jay-hamlin/charlieplexClock/Clock_README.rtf

7 segment clock using LED filaments.
Last update 24, March 2022.
Jay Hamlin

HISTORY
The inspiration for this project came from one of Big Clive’s YouTube videos in which he was showing low voltage LED filaments. This was new to me, I didn’t know that there were LED filaments that ran on 3 Volts. I bought some 38mm white, 3 Volt filaments on AliExpress and soldered them together as a 7 segment digit on a prototyping board just to see what they would look like. It looked ok but I didn’t know what I would do with it. Later I bought some 20mm red filaments , their color is more red-orange which reminded me of neon. The LED Nixie tube was born!

My first take on the LED nixie was to solder 7 segments together in free space using heavy gauge wires for the supports on the bottom segments and the finest wire I could find (10um diameter!) for the others thinking this would look most like a Nixie tube. It looked good but the 10um wire was very difficult to work with and it took forever to hand solder the segments. I didn’t think I could make any two that looked alike even after making a simple jig to hold the segments in place.

I tried putting the hand made digit into a small glass jar as the first try at making the tube part of the Nixie tube. It worked but the shape of the jar wasn’t very good, not so tube like. Then I had the idea to use a laboratory test tube with a rounded end. You can get test tubes made from plastic on Amazon for cheap - the product description says that the tubes are 2 liter soda bottles before they have been expanded. Perfect!

Then I decided that it would be ok to use a black pcb to hold the segments, this way every digit would come out the same and it would be much easier to assemble so I made a pcb sized to fit inside the test tube. I used OSHPark to fab the boards using their After Dark service for the black substrate.

By the way, the 20mm filaments have an active (light emitting) length of only 11mm. I made the pcb with solder pads 14mm apart and a slot for the LED 11.5mm long by 2.0mm wide. This size works really well although you do have to trim some of the extra metal off of the ends of the filament and trim the silicone just a bit with an Exacto knife.

The clock is my way of showing off the LED Nixie tubes with something interesting. What else would I have made? A frequency counter perhaps but the clock seemed more useful. I choose Adafruit’s HUZZAH32 Feather board with the ESP32 because it had WiFi and I could program it in circuit python which sounded like something which would be good to learn. When I got into it, I ended up porting the Arduino Uno single digit code to the ESP32 and the 6 74LV595 shift registers and had a working Arduino project before I could even start with the circuit python. So, Arduino it is, circuit python for some other day!

CHARLIEPLEXING
wiki entry: https://en.wikipedia.org/wiki/Charlieplexing
YouTube explainer: https://youtu.be/Bx5GLyJSWPk

Why did I use Charlieplexing for this project? Because I wanted the segments to be as close to each other as possible - connecting them together at each intersection was the simplest and most direct method. Also, the prototype digit was made without any pcb, the solder connections were also the mechanical mounting points of the segments, they couldn’t be wired in the more conventional common cathode or common anode arrangement and hold together.

HARDWARE
The schematics and pcb were designed in KiCAD 5.1.12. There are 2 projects, one for the digit pcb and another for the main board.

A complete clock is made up of 3 boards:
1- One main pcb
2- Six digit pcbs which plug into the main pcb at J3, J4, J6, J7, J9 and J10.
3- Two colon pcbs which plug into the main pcb at J5 and J8.

DIGIT PCB:
KiCAD_Project/7SegmentCharlie.pro
The digit pcb schematic PDF is: KiCAD_Project/7segmentCharlie.pdf
MAIN BOARD:
KiCAD_Project/6DigitCharlieplex.pro
The main board pcb schematic PDF is: KiCAD_Project/ClockSchematic_02232222.pdf
COLON PCB:
/Documentation/colon_dim_drawing.pdf
There are no KiCAD files for the colons, these were hand made from prototyping boards. The “schematic” is in the drawing file.

BILL OF MATERIALS:
KiCAD_Project/BOM_03232022.xlsx

DOCUMENTS
/Documentation/Arduino_Proto_7seg_Display.pdf
The original schematic for the Arduino Uno digit prototype. Note that the LED for segment D is shown backwards, I actually had it this way at first but then realized all the horizontal segments should all go in the same direction. In fact, by having all the segments in the same direction, the port bits never needed to be in the tri-state state, just ‘1’ or ‘0’ would work which is important in the final clock which uses ‘595 shift registers.
/Documentation/Charlieplex_digit_decoder.pdf
Explanation of how each digit connects to the 74LV595 shift register and the values software writes to produce numbers.
/Documentation/mlb_dim_drawing2.pdf
A dimensioned drawing of the main board.
/Documentation/digit_dim_drawing.pdf
A dimensioned drawing of the digit board.
/Documentation/colon_dim_drawing.pdf
A dimensioned drawing of the colon board.

SOFTWARE
There are 2 Arduino projects as follows:
Arduino/charley7/
Charlie7 is the single digit prototype project running on an Arduino Uno.
The Charlie7 digit schematic is Documentation/Arduino_Proto_7seg_Display.pdf

Arduino/FilamentClock_ESP32/
FilamentClock_ESP32 is the full clock project. It uses the Adafruit HUZZAH32 ESP32 Feather board module. Follow the instructions on Adafruit for getting the HUZZAH32 running with Arduino here: https://learn.adafruit.com/adafruit-huzzah32-esp32-feather/using-with-arduino-ide

LINKS TO LED FILAMENTS:

20mm, 3V, 100mA used in this project: 20mm Filament (https://www.aliexpress.com/item/1005003509056672.html?spm=a2g0o.order_list.0.0.21ef18028wNrUJ). These come in white, red, green, blue and pink. I used the red ones for my project, they look more orange to me which is how I got the Nixie tube inspiration. This is a 6 digit clock which uses 7 filaments per digit or 42 filaments total.

The original prototype Charlieplexed 7 segment digit used 38mm filaments: 38mm filament (https://www.aliexpress.com/item/4000478265055.html). I could have made the clock using these but they seemed just a little too big.

I have also played with 130mm filaments I call “LED spaghetti” but haven’t attempted to make anything with them. Still, they look cool. LED Spaghetti (https://www.aliexpress.com/item/1005001685226898.html?spm=a2g0o.order_list.0.0.21ef18028wNrUJ)

ACRYLIC “TUBES”
I used 25mm diameter plastic test tubes from Amazon then cut them to the size I wanted.
Amazon link: https://www.amazon.com/dp/B07RX6HQPB?psc=1&ref=ppx_yo2_dt_b_product_details

GIT NOTES
git status
git add <file>
git rm <file>
git commit -m “chekin comment”
git push -u origin master
