jay-hamlin/charlieplexClock/Arduino/FilamentClock_ESP32/notes_esp32.rtf

Example code

https://github.com/espressif/arduino-esp32/tree/master/libraries

For the Jar pcb we need
