jay-hamlin/charlieplexClock/KiCAD_Project/BOM_03232022.xlsx

Reference | Count | Value | Footprint | Description | Manufacturer | MPN | Vendor | Vendor PN
C3,C4,C5,C7,C9,C10,C11 | 7 | 100nF | Capacitor_SMD:C_0603_1608Metric | CAP CER 0.1UF 16V X7R 0603 | Yageo | CC0603JRX7R7BB104 | Digikey | 311-1776-1-ND
C6 | 1 | 1uF, 0603 | Capacitor_SMD:C_0603_1608Metric | CAP CER 1UF 16V X7R 0603 | TDK | CGA3E1X7R1C105K080AC | Digikey | 445-12539-1-ND
C8 | 1 | 10uF, 0805 | Capacitor_SMD:C_0805_2012Metric | CAP CER 22UF 10V X5R 0805 | Murata | GRM21BR61A226ME51L | Digikey | 490-10511-1-ND
D13,D14 | 2 | RED_LED | LED_SMD:LED_1206_3216Metric | LED RED CLEAR 1206 SMD | Lite-ON | LTST-C150KRKT | Digikey | 160-1405-1-ND
R1,R2,R3,R4,R5,R6,R7,R8,R9,R10,R11,R12,R15,R16,R17,R18,R19,R20,R23,R24,R25,R26,R27,R28,R29,R30,R31,R32,R33,R34,R37,R38,R39,R40,R41,R42 | 36 | 10R | Resistor_SMD:R_0603_1608Metric | RES 10 OHM 1% 1/8W 0603 | Stackpole | RNCP0603FTD10R0 | Digikey | RNCP0603FTD10R0CT-ND
R21,R22,R35,R36 | 4 | 120R | Resistor_SMD:R_0603_1608Metric | RES 120 OHM 1% 1/10W 0603 | Yageo | RC0603FR-07120RL | Digikey | 311-120HRCT-ND
R13,R14 | 2 | 1K | Resistor_SMD:R_0603_1608Metric | RES SMD 1K OHM 1% 1/3W 0603 | Vishay | CRCW06031K00FKEAHP | Digikey | 541-1.00KSCT-ND
R44 | 1 | 63.4K,1% | Resistor_SMD:R_0603_1608Metric | RES 63.4K OHM 1% 1/10W 0603 | Stackpole | RMCF0603FT63K4 | Digikey | RMCF0603FT63K4CT-ND
R43,R45,R46,R47,R48,R49,R50,R51 | 8 | 100K,1% | Resistor_SMD:R_0603_1608Metric | RES 100K OHM 1% 1/16W 0603 | Yageo | AF0603FR-07100KL | Digikey | 13-AF0603FR-07100KLCT-ND
RV1 | 1 | 10.0K | Potentiometer_THT:Potentiometer_Bourns_3386C_Horizontal | TRIMMER 10K OHM 0.5W PC PIN SIDE | Bourns | 3386H-1-103LF | Digikey | 3386H-103LF-ND
J1,J2,J3,J4,J6,J7,J9,J10 | 8 | Conn_01x06_Female | Connector_PinHeader_2.54mm:PinHeader_1x06_P2.54mm_Vertical | CONN RCPT 6POS 0.1 TIN-LEAD PCB | 3M | 929974-01-06 | Digikey | 929974-01-06-ND
J5,J8 | 2 | Conn_01x03_Female | Connector_PinHeader_2.54mm:PinHeader_1x03_P2.54mm_Vertical | CONN RCPT 3POS 0.1 TIN-LEAD PCB | 3M | 929974-01-03 | Digikey | 929974-01-03-ND
JP1_Feather1 | 1 | Feather_16pin | Connector_PinHeader_2.54mm:PinHeader_1x16_P2.54mm_Vertical | CONN RCPT 16POS 0.1 TIN PCB | 3M | 929974-01-16-RK | Digikey | 929974E-01-16-ND
JP3_Feather1 | 1 | Feather_12pin | Connector_PinHeader_2.54mm:PinHeader_1x12_P2.54mm_Vertical | CONN RCPT 12POS 0.1 TIN PCB | 3M | 929974-01-12-RK | Digikey | 929974-01-12-ND
SW1,SW2,SW3,SW4 | 4 | SW_Push | Button_Switch_SMD:SW_SPST_PTS645 | SWITCH TACTILE SPST-NO 0.05A 12V | C&K | PTS645SH50SMTR92 LFS | Digikey | CKN9085CT-ND
SW5 | 1 | SW_DIP_x03 | Package_DIP:DIP-6_W8.89mm_SMDSocket_LongPads | SWITCH SLIDE DIP SPST 100MA 20V | CTS | 219-3LPSTR | Digikey | CT3115CT-ND
U1,U2,U4,U5,U6,U7 | 6 | 74LV595D,118 | Package_SO:SO-16_3.9x9.9mm_P1.27mm | IC 8BIT SHIFT REGISTER 16SOIC | Nexperia | 74LV595D,118 | Digikey | 1727-7348-1-ND
U3 | 1 | NCV8164ASNADJT1G | Package_TO_SOT_SMD:TSOT-23-5 | IC REG LIN POS ADJ 300MA 5TSOP | ON Semi | NCV8164ASNADJT1G | Digikey | 488-NCV8164ASNADJT1GCT-ND
HUZZAH32 | 1 | ESP32 Feather | custom | ESP32 Feather boar HUZZAH32 | Adafruit | 3405 | Adafruit | 3405
LED Filaments | 42 | 20mm,RED,3V |  | AliExpress https://www.aliexpress.com/item/1005003509056672.html?spm=a2g0o.order_list.0.0.21ef18028wNrUJ
Digit PCB | 1 |  |  | OSHPark, "After Dark", black substrate and clear soldermask
Main PCB | 1 |  |  | OSHPark, "After Dark", black substrate and clear soldermask
