jay-hamlin/charlieplexClock/Documentation/Arduino_Proto_7seg_Display.pdf

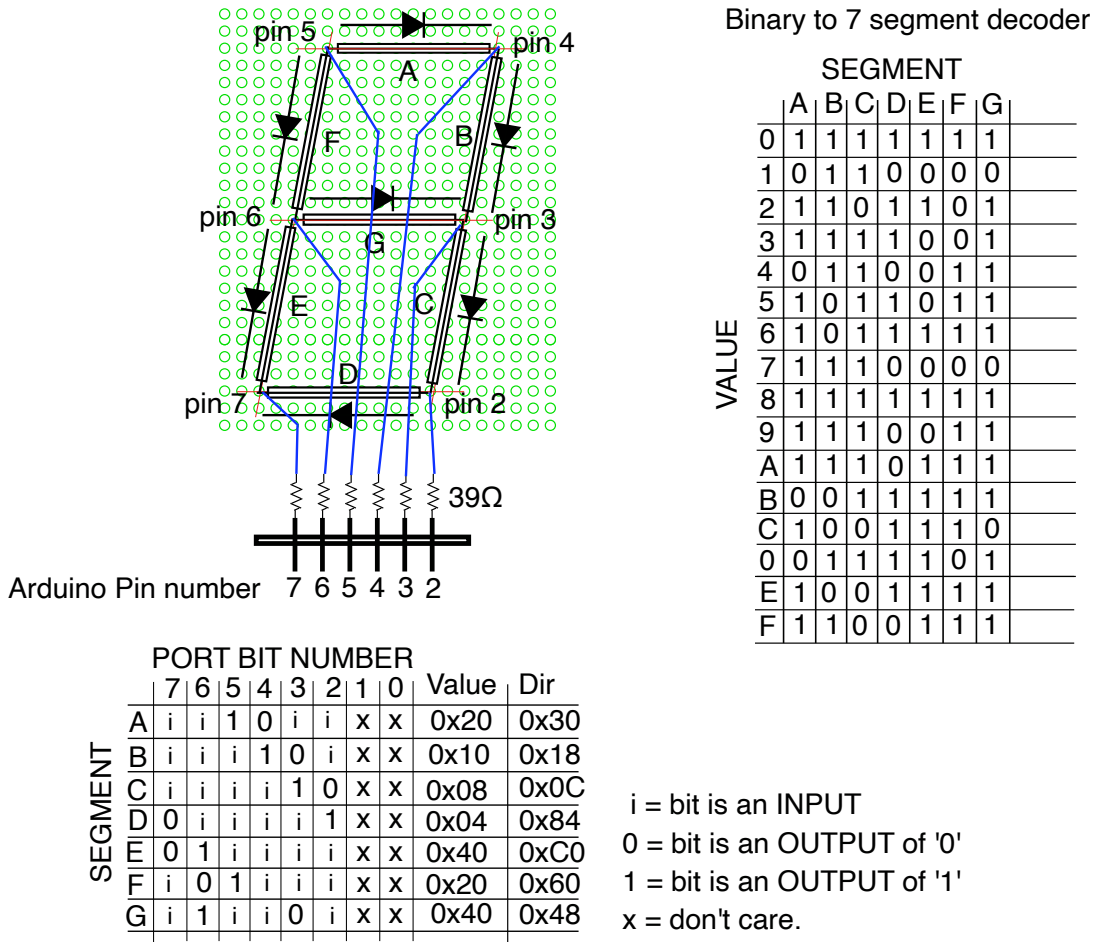
[picture p1: page 1]
PORT BIT NUMBER; SEGMENT; Value; Dir 0x30 0x18 0x0C 0x84 0xC0 0x60 0x48; VALUE; pin 4; pin 3; pin 7; pin 2; pin 6; pin 5

Binary to 7 segment decoder

Arduino Pin number

i = bit is an INPUT
0 = bit is an OUTPUT of '0'
1 = bit is an OUTPUT of '1'
x = don't care.
