jay-hamlin/charlieplexClock/Documentation/Charlieplex_digit_decoder.pdf

# CHARLIEPLEXED CLOCK DIGIT DECODER

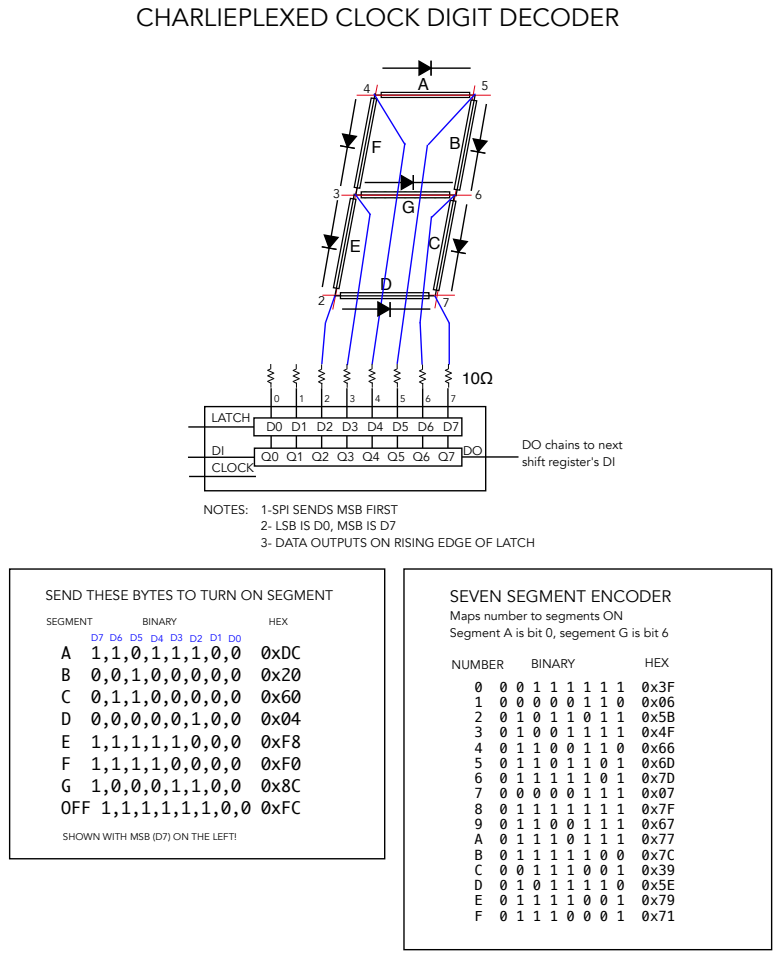
[picture p2: page 1]

DO chains to next
shift register's DI

NOTES: 1-SPI SENDS MSB FIRST

2- LSB IS D0, MSB IS D7
3- DATA OUTPUTS ON RISING EDGE OF LATCH

SEND THESE BYTES TO TURN ON SEGMENT

SEVEN SEGMENT ENCODER
Maps number to segments ON
Segment A is bit 0, segement G is bit 6

SHOWN WITH MSB (D7) ON THE LEFT!
