jay-hamlin/charlieplexClock/Documentation/colon_dim_drawing.pdf

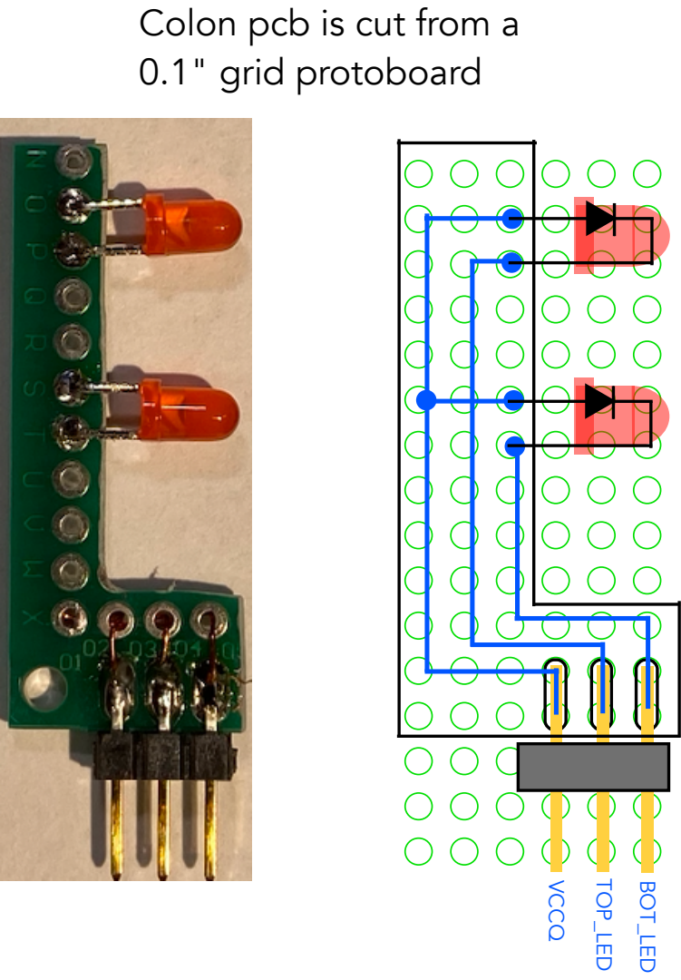
[picture p3: page 1]
VCCQ; TOP_LED; BOT_LED

Colon pcb is cut from a
0.1" grid protoboard
