jay-hamlin/charlieplexClock/KiCAD_Project/ClockSchematic_02232222.pdf

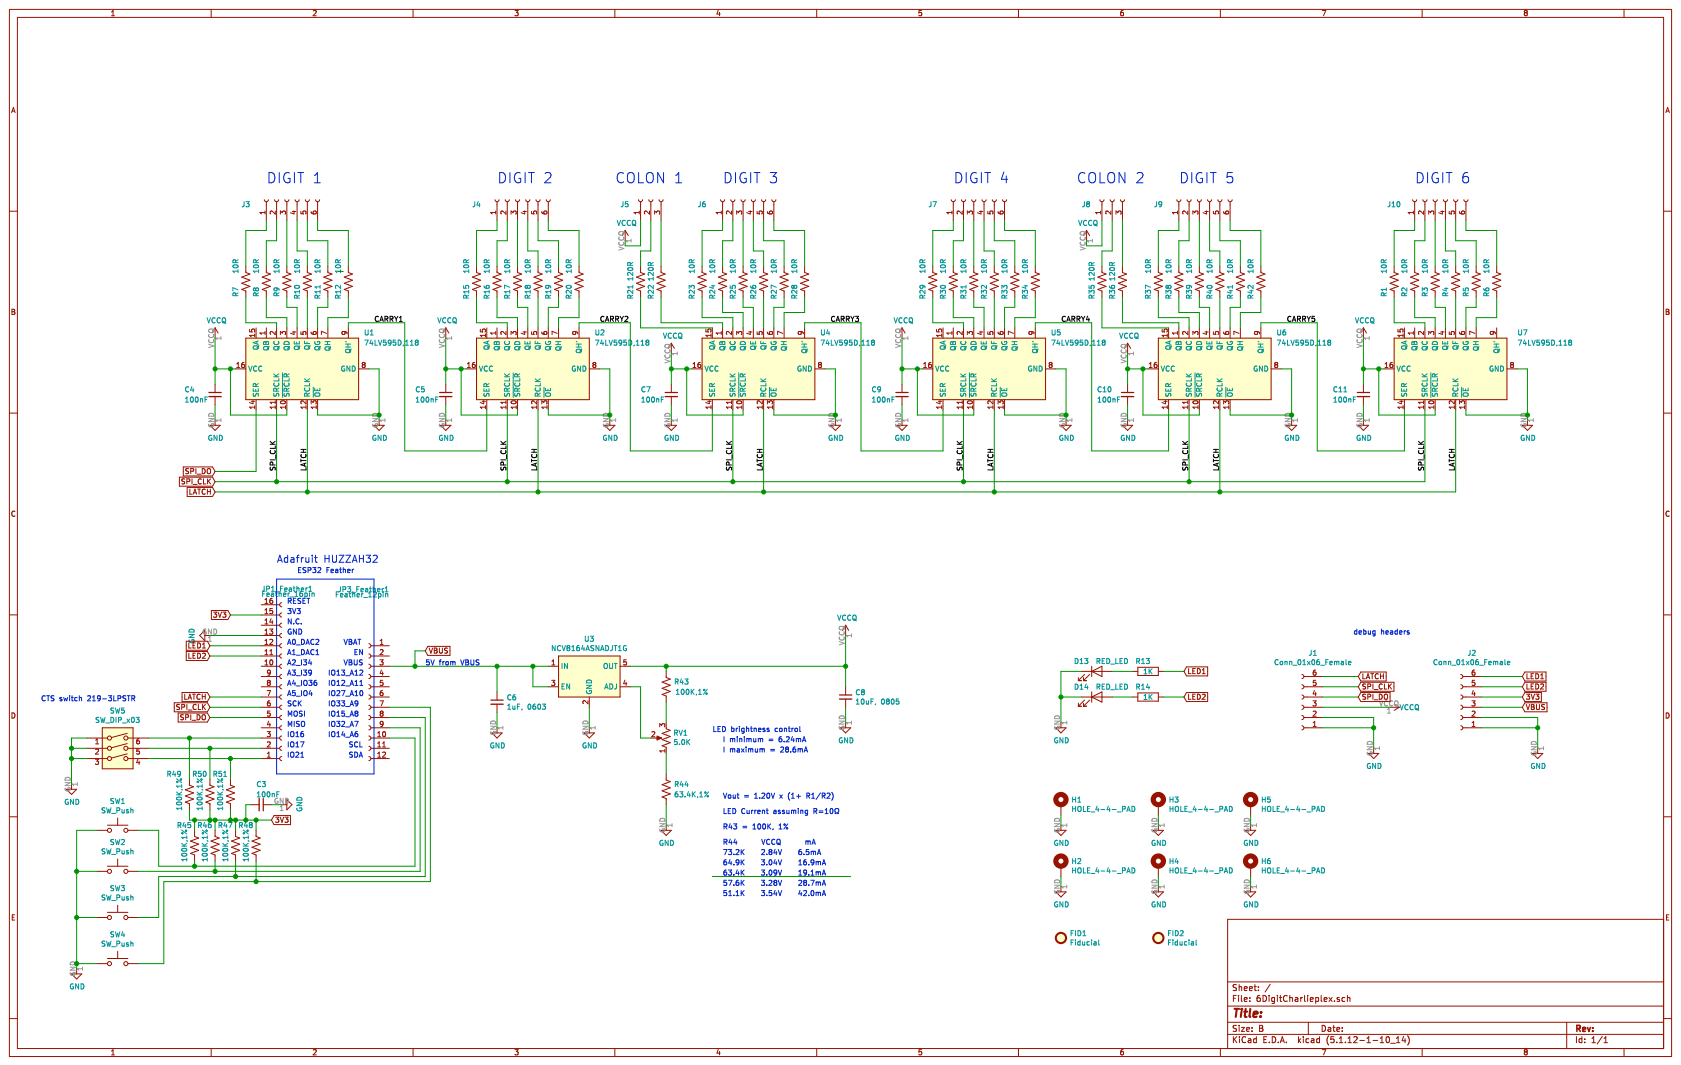
[picture p4: page 1]
