jay-hamlin/charlieplexClock/Documentation/digit_dim_drawing.pdf

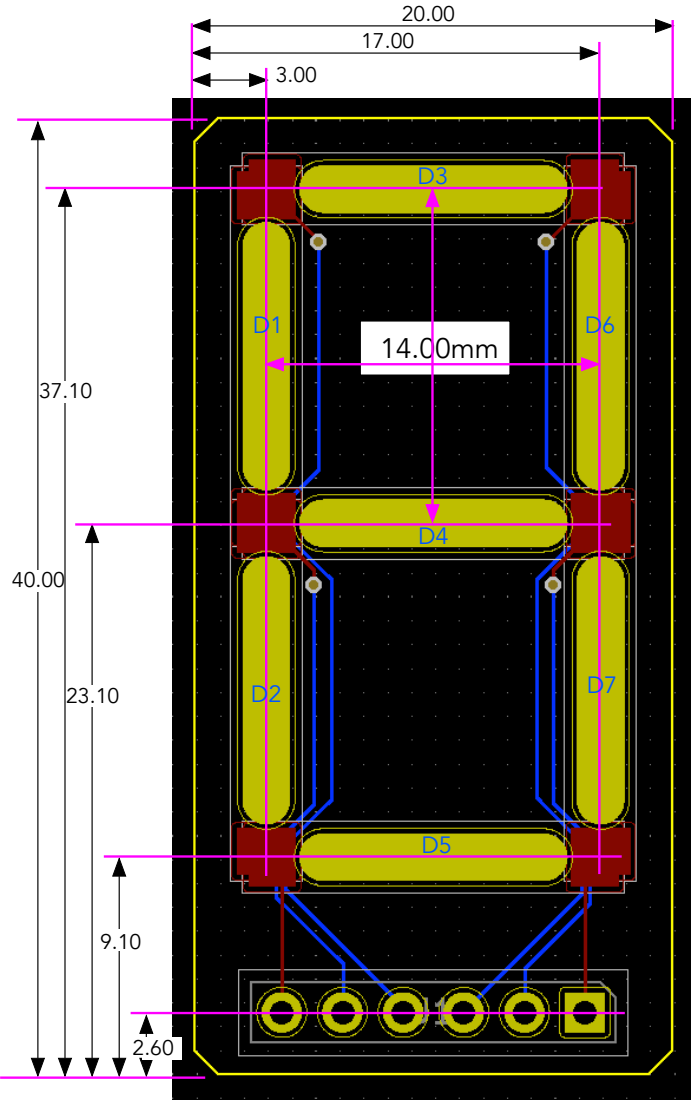
[picture p5: page 1]
