jay-hamlin/charlieplexClock/Documentation/mlb_dim_drawing2.pdf

194.15
50.00

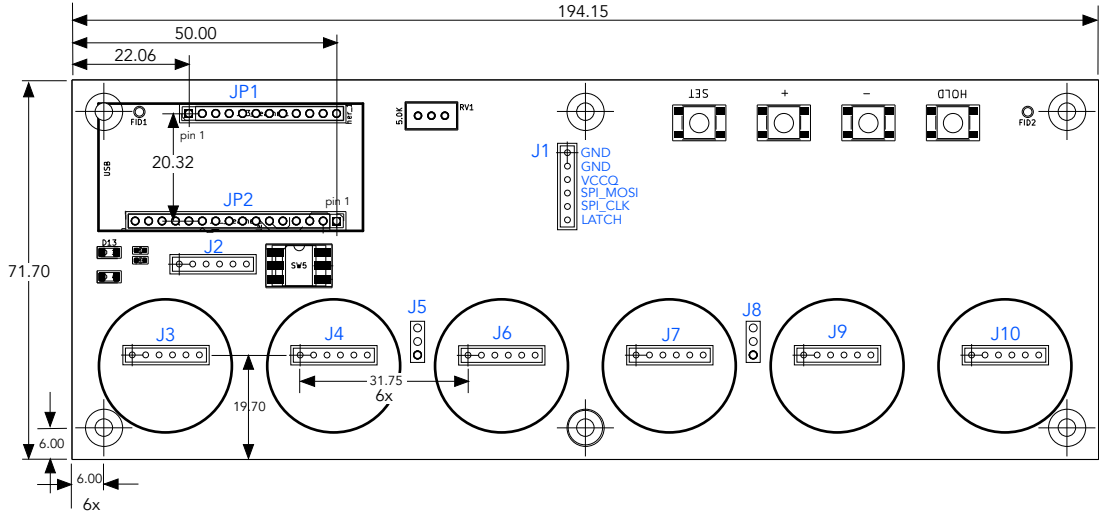
[picture p6: page 1]
