jay-hamlin/charlieplexClock/KiCAD_Project/7segmentCharlie.pdf

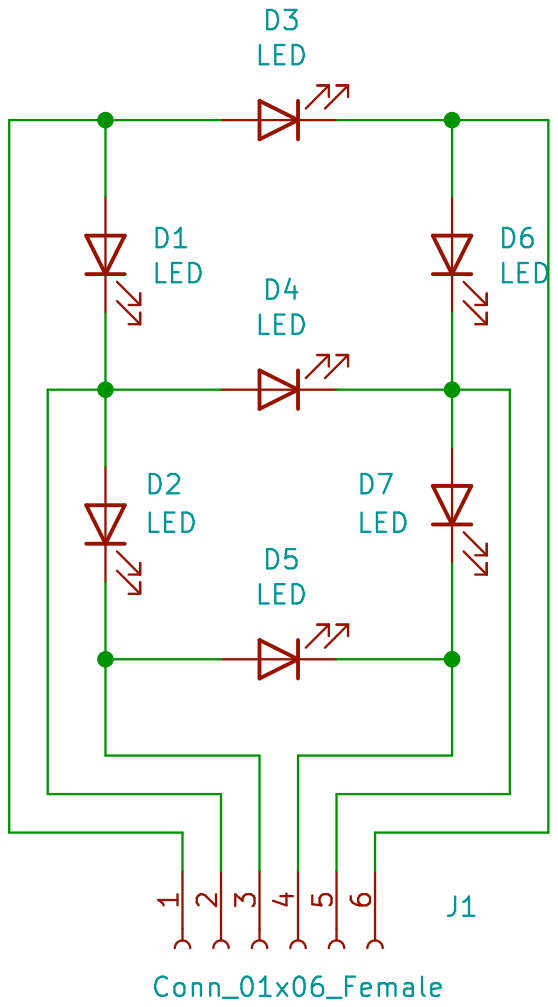
[picture p7: page 1]
