jay-hamlin/charlieplexClock/KiCAD_Project/6DigitCharlieplex.kicad_pcb

## KiCad design KiCAD_Project/6DigitCharlieplex.kicad_pcb (2022-03-25)

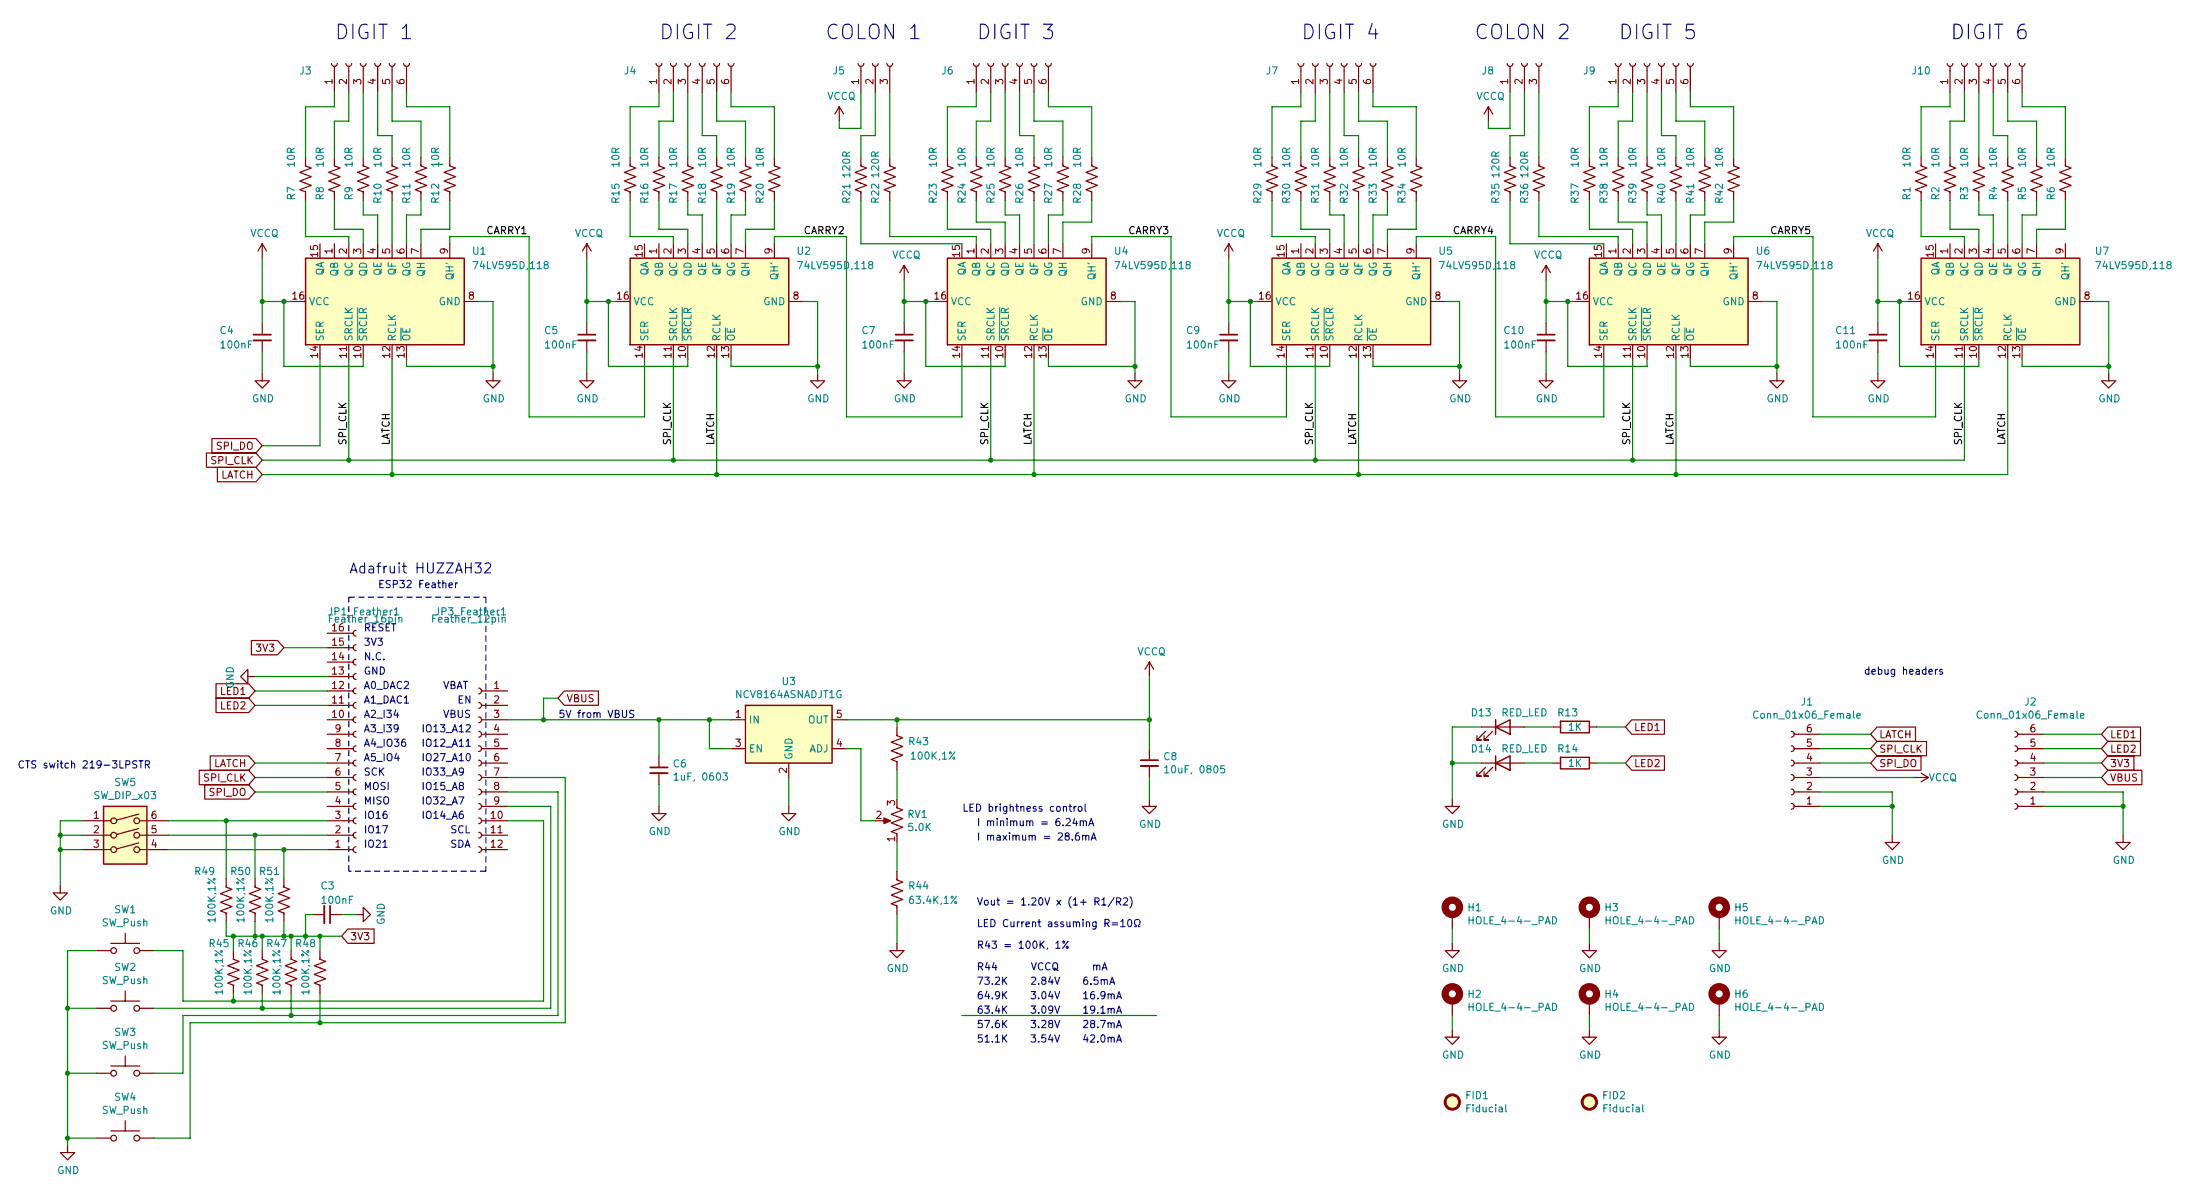
[picture p8: schematic 6DigitCharlieplex.sch]

Parts:
C3, C4, C5, C7, C9, C10, C11: 100nF; C_0603_1608Metric
C6: 1uF, 0603; C_0603_1608Metric
C8: 10uF, 0805; C_0805_2012Metric
D13, D14: RED_LED; LED_1206_3216Metric
FID1, FID2: Fiducial; Fiducial_0.5mm_Mask1.5mm
H1, H2, H3, H4, H5, H6: HOLE_4-4-_PAD; MountingHole_3.2mm_M3_Pad
J1, J2, J3, J4, J6, J7, J9, J10: Conn_01x06_Female; PinHeader_1x06_P2.54mm_Vertical
J5, J8: Conn_01x03_Female; PinHeader_1x03_P2.54mm_Vertical
JP1_Feather1: Feather_16pin; PinHeader_1x16_P2.54mm_Vertical
JP3_Feather1: Feather_12pin; PinHeader_1x12_P2.54mm_Vertical
R1, R2, R3, R4, R5, R6, R7, R8, R9, R10, R11, R12, R15, R16, R17, R18, R19, R20, R23, R24, R25, R26, R27, R28, R29, R30, R31, R32, R33, R34, R37, R38, R39, R40, R41, R42: 10R; R_0603_1608Metric
R13, R14: 1K; R_0603_1608Metric
R21, R22, R35, R36: 120R; R_0603_1608Metric
R43, R45, R46, R47, R48, R49, R50, R51: 100K,1%; R_0603_1608Metric
R44: 63.4K,1%; R_0603_1608Metric
RV1: 5.0K; Potentiometer_Bourns_3386C_Horizontal
SW1, SW2, SW3, SW4: SW_Push; SW_SPST_PTS645
SW5: SW_DIP_x03; DIP-6_W8.89mm_SMDSocket_LongPads
U1, U2, U4, U5, U6, U7: 74LV595D,118; SO-16_3.9x9.9mm_P1.27mm
U3: NCV8164ASNADJT1G; TSOT-23-5

Connections:
3V3: C3.2, J2.4, JP1_Feather1.15, R45.1, R46.1, R47.1, R48.1, R49.2, R50.2, R51.2
/CARRY1: U1.9 (QH'), U2.14 (SER)
/CARRY2: U2.9 (QH'), U4.14 (SER)
/CARRY3: U4.9 (QH'), U5.14 (SER)
/CARRY4: U5.9 (QH'), U6.14 (SER)
/CARRY5: U6.9 (QH'), U7.14 (SER)
GND: C3.1, C4.2, C5.2, C6.2, C7.2, C8.2, C9.2, C10.2, C11.2, D13.1 (K), D14.1 (K), H1.1, H2.1, H3.1, H4.1, H5.1, H6.1, J1.1, J1.2, J2.1, J2.2, JP1_Feather1.13, R44.2, SW1.1, SW2.1, SW3.1, SW4.1, SW5.1, SW5.2, SW5.3, U1.8 (GND), U1.13 (~OE), U2.8 (GND), U2.13 (~OE), U3.2 (GND), U4.8 (GND), U4.13 (~OE), U5.8 (GND), U5.13 (~OE), U6.8 (GND), U6.13 (~OE), U7.8 (GND), U7.13 (~OE)
LATCH: J1.6, JP1_Feather1.7, U1.12 (RCLK), U2.12 (RCLK), U4.12 (RCLK), U5.12 (RCLK), U6.12 (RCLK), U7.12 (RCLK)
LED1: J2.6, JP1_Feather1.12, R13.1
LED2: J2.5, JP1_Feather1.11, R14.1
unnamed: D13.2 (A), R13.2
unnamed: D14.2 (A), R14.2
unnamed: J3.1, R7.1
unnamed: J3.2, R8.1
unnamed: J3.3, R9.1
unnamed: J3.4, R10.1
unnamed: J3.5, R11.1
unnamed: J3.6, R12.1
unnamed: J4.1, R15.1
unnamed: J4.2, R16.1
unnamed: J4.3, R17.1
unnamed: J4.4, R18.1
unnamed: J4.5, R19.1
unnamed: J4.6, R20.1
unnamed: J5.2, R21.1
unnamed: J5.3, R22.1
unnamed: J6.1, R23.1
unnamed: J6.2, R24.1
unnamed: J6.3, R25.1
unnamed: J6.4, R26.1
unnamed: J6.5, R27.1
unnamed: J6.6, R28.1
unnamed: J7.1, R29.1
unnamed: J7.2, R30.1
unnamed: J7.3, R31.1
unnamed: J7.4, R32.1
unnamed: J7.5, R33.1
unnamed: J7.6, R34.1
unnamed: J8.2, R35.1
unnamed: J8.3, R36.1
unnamed: J9.1, R37.1
unnamed: J9.2, R38.1
unnamed: J9.3, R39.1
unnamed: J9.4, R40.1
unnamed: J9.5, R41.1
unnamed: J9.6, R42.1
unnamed: J10.1, R1.1
unnamed: J10.2, R2.1
unnamed: J10.3, R3.1
unnamed: J10.4, R4.1
unnamed: J10.5, R5.1
unnamed: J10.6, R6.1
unnamed: JP1_Feather1.1, R51.1, SW5.4
unnamed: JP1_Feather1.2, R50.1, SW5.5
unnamed: JP1_Feather1.3, R49.1, SW5.6
unnamed: JP3_Feather1.7, R48.2, SW4.2
unnamed: JP3_Feather1.8, R47.2, SW3.2
unnamed: JP3_Feather1.9, R46.2, SW2.2
unnamed: JP3_Feather1.10, R45.2, SW1.2
unnamed: R1.2, U7.2 (QC)
unnamed: R2.2, U7.3 (QD)
unnamed: R3.2, U7.4 (QE)
unnamed: R4.2, U7.5 (QF)
unnamed: R5.2, U7.6 (QG)
unnamed: R6.2, U7.7 (QH)
unnamed: R7.2, U1.2 (QC)
unnamed: R8.2, U1.3 (QD)
unnamed: R9.2, U1.4 (QE)
unnamed: R10.2, U1.5 (QF)
unnamed: R11.2, U1.6 (QG)
unnamed: R12.2, U1.7 (QH)
unnamed: R15.2, U2.2 (QC)
unnamed: R16.2, U2.3 (QD)
unnamed: R17.2, U2.4 (QE)
unnamed: R18.2, U2.5 (QF)
unnamed: R19.2, U2.6 (QG)
unnamed: R20.2, U2.7 (QH)
unnamed: R21.2, U4.15 (QA)
unnamed: R22.2, U4.1 (QB)
unnamed: R23.2, U4.2 (QC)
unnamed: R24.2, U4.3 (QD)
unnamed: R25.2, U4.4 (QE)
unnamed: R26.2, U4.5 (QF)
unnamed: R27.2, U4.6 (QG)
unnamed: R28.2, U4.7 (QH)
unnamed: R29.2, U5.2 (QC)
unnamed: R30.2, U5.3 (QD)
unnamed: R31.2, U5.4 (QE)
unnamed: R32.2, U5.5 (QF)
unnamed: R33.2, U5.6 (QG)
unnamed: R34.2, U5.7 (QH)
unnamed: R35.2, U6.15 (QA)
unnamed: R36.2, U6.1 (QB)
unnamed: R37.2, U6.2 (QC)
unnamed: R38.2, U6.3 (QD)
unnamed: R39.2, U6.4 (QE)
unnamed: R40.2, U6.5 (QF)
unnamed: R41.2, U6.6 (QG)
unnamed: R42.2, U6.7 (QH)
unnamed: R43.2, RV1.3
unnamed: R44.1, RV1.1
unnamed: RV1.2, U3.4 (ADJ)
SPI_CLK: J1.5, JP1_Feather1.6, U1.11 (SRCLK), U2.11 (SRCLK), U4.11 (SRCLK), U5.11 (SRCLK), U6.11 (SRCLK), U7.11 (SRCLK)
SPI_DO: J1.4, JP1_Feather1.5, U1.14 (SER)
VBUS: C6.1, J2.3, JP3_Feather1.3, U3.1 (IN), U3.3 (EN)
VCCQ: C4.1, C5.1, C7.1, C8.1, C9.1, C10.1, C11.1, J1.3, J5.1, J8.1, R43.1, U1.10 (~SRCLR), U1.16 (VCC), U2.10 (~SRCLR), U2.16 (VCC), U3.5 (OUT), U4.10 (~SRCLR), U4.16 (VCC), U5.10 (~SRCLR), U5.16 (VCC), U6.10 (~SRCLR), U6.16 (VCC), U7.10 (~SRCLR), U7.16 (VCC)

Notes on the sheet:
Adafruit HUZZAH32
ESP32 Feather
RESET
3V3
N.C.
GND
A0_DAC2
A1_DAC1
A2_I34
A3_I39
A4_IO36
A5_IO4
SCK
MOSI
MISO
IO16
IO17
IO21
VBAT
VBUS
IO13_A12
IO12_A11
IO27_A10
IO33_A9
IO15_A8
IO32_A7
IO14_A6
SCL
SDA
Vout = 1.20V x (1+ R1/R2)
LED Current assuming R=10Ω
R43 = 100K, 1%
R44 VCCQ mA
73.2K 2.84V 6.5mA
64.9K 3.04V 16.9mA
63.4K 3.09V 19.1mA
57.6K 3.28V 28.7mA
51.1K 3.54V 42.0mA
5V from VBUS
LED brightness control
I minimum = 6.24mA
I maximum = 28.6mA
debug headers
DIGIT 1
DIGIT 2
DIGIT 3
DIGIT 4
DIGIT 5
DIGIT 6
COLON 1
COLON 2
CTS switch 219-3LPSTR

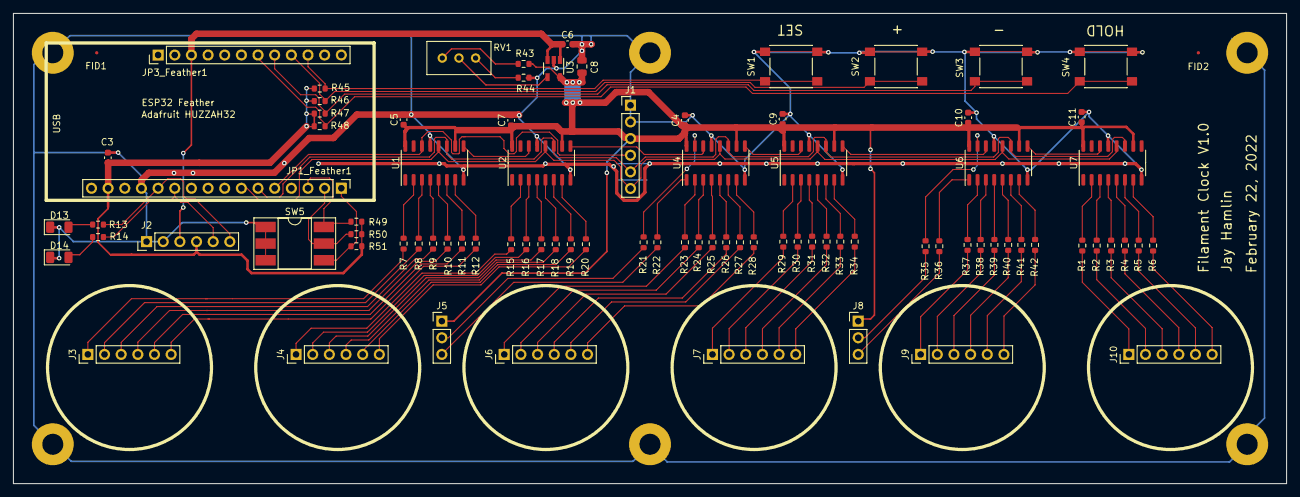
[picture p9: board 6DigitCharlieplex.kicad_pcb from above]

Board: 2 copper layers, 194.1 x 71.7 mm, 95 parts (0 on the bottom side), 106 nets.
