jay-hamlin/charlieplexClock/KiCAD_Project/7SegmentCharlie.kicad_pcb

## KiCad design KiCAD_Project/7SegmentCharlie.kicad_pcb (2022-03-25)

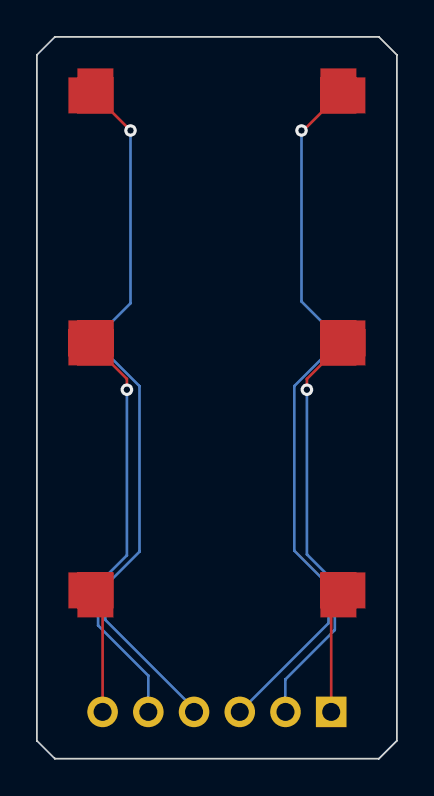
[picture p10: board 7SegmentCharlie.kicad_pcb from above]

Board: 2 copper layers, 20.0 x 40.1 mm, 8 parts (0 on the bottom side), 6 nets.

Parts:
D1, D2, D3, D4, D5, D6, D7: LED; LEDFilament_12mm
J1: Conn_01x06_Female; PinHeader_1x06_P2.54mm_NoSilk

Connections:
unnamed: D1.1, D2.2, D4.2, J1.5
unnamed: D1.2, D3.2, J1.4
unnamed: D2.1, D5.2, J1.6
unnamed: D3.1, D6.2, J1.3
unnamed: D4.1, D6.1, D7.2, J1.2
unnamed: D5.1, D7.1, J1.1
